j-dunc/POV-Display-V2/mechanical/solidworks/top_decal.png

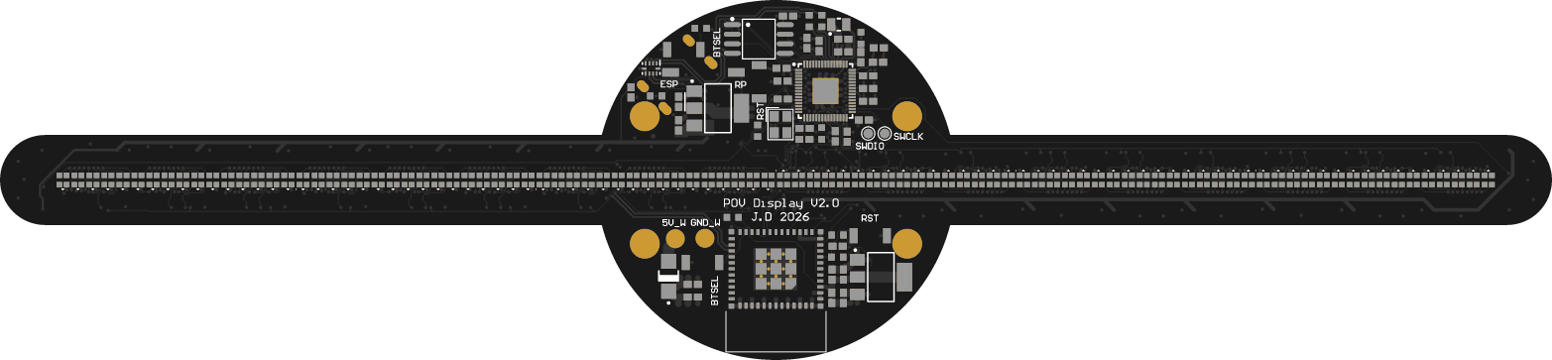
mechanical/solidworks/top_decal.png
