j-dunc/POV-Display-V2/hardware/fabrication/POV_DisplayV2-BOM.xlsx

Name | Description | Designator | Quantity | Manufacturer 1 | Manufacturer Part Number 1
Cap 100nF 0603 | 100nF 50V 10% X7R 0603 SMD Capacitor Decoupling | C1, C3, C4, C5, C6, C7, C8, C9, C10, C11, C12, C17, C23, C28_U_16_RGBs1, C28_U_16_RGBs2, C28_U_16_RGBs3, C28_U_16_RGBs4, C28_U_16_RGBs5, C28_U_16_RGBs6, C29_U_16_RGBs1, C29_U_16_RGBs2, C29_U_16_RGBs3, C29_U_16_RGBs4, C29_U_16_RGBs5, C29_U_16_RGBs6, C30_U_16_RGBs1, C30_U_16_RGBs2, C30_U_16_RGBs3, C30_U_16_RGBs4, C30_U_16_RGBs5, C30_U_16_RGBs6, C32, C34, C37 | 34 | Yageo Group | CC0603KRX7R9BB104
Cap 4.7uF 0603 | 4.7uF 16V 10% X5R 0603 SMD Capacitor | C2, C14, C15, C16 | 4 | Yageo Group | CC0603KRX5R8BB475
Cap 22uF 0603 | 22uF 6.3V 20% X5R 0603 SMD Capacitor | C13, C22, C31_U_16_RGBs1, C31_U_16_RGBs2, C31_U_16_RGBs3, C31_U_16_RGBs4, C31_U_16_RGBs5, C31_U_16_RGBs6, C33 | 9 | Samsung Electro-Mechanics | CL10A226MQ8NRNC
Cap 15pF 0603 | 15pF 50V 5% C0G 0603 SMD Capacitor | C18, C19 | 2 | Yageo Group | C0603C150K5GACTU
Cap 10uF 0603 | 10uF 6.3V 10% X5R 0603 SMD Capacitor | C20, C21, C35, C36 | 4 | Yageo Group | CC0603KRX5R5BB106
Cap 4.7nF 0603 | 4.7nF 50V 10% X7R 0603 SMD Capacitor | C24, C27 | 2 | Yageo Group | C0603C472J3RACTU
Cap 1nF 0603 | 1nF 50V 10% X7R 0603 SMD Capacitor | C25, C26 | 2 | Yageo Group | C0603C102F3GACAUTO
MBRA140T3G | Schottky Barrier Rectifier Diode 40 Volt 1A Automotive 2-Pin SMA | D1, D2 | 2 | onsemi | MBRA140T3G
AOTA-B201610S3R3-101-T | General Purpose Inductor, 3.3uH, 20%, 1 Element, SMD, 0806 | L1 | 1 | Abracon | AOTA-B201610S3R3-101-T
EKINGLUX E6C0606RGBC3UDA | 1.6*1.6*0.6mm RGB SMD CHIP LED | LED1_U_16_RGBs1, LED1_U_16_RGBs2, LED1_U_16_RGBs3, LED1_U_16_RGBs4, LED1_U_16_RGBs5, LED1_U_16_RGBs6, LED2_U_16_RGBs1, LED2_U_16_RGBs2, LED2_U_16_RGBs3, LED2_U_16_RGBs4, LED2_U_16_RGBs5, LED2_U_16_RGBs6, LED3_U_16_RGBs1, LED3_U_16_RGBs2, LED3_U_16_RGBs3, LED3_U_16_RGBs4, LED3_U_16_RGBs5, LED3_U_16_RGBs6, LED4_U_16_RGBs1, LED4_U_16_RGBs2, LED4_U_16_RGBs3, LED4_U_16_RGBs4, LED4_U_16_RGBs5, LED4_U_16_RGBs6, LED5_U_16_RGBs1, LED5_U_16_RGBs2, LED5_U_16_RGBs3, LED5_U_16_RGBs4, LED5_U_16_RGBs5, LED5_U_16_RGBs6, LED6_U_16_RGBs1, LED6_U_16_RGBs2, LED6_U_16_RGBs3, LED6_U_16_RGBs4, LED6_U_16_RGBs5, LED6_U_16_RGBs6, LED7_U_16_RGBs1, LED7_U_16_RGBs2, LED7_U_16_RGBs3, LED7_U_16_RGBs4, LED7_U_16_RGBs5, LED7_U_16_RGBs6, LED8_U_16_RGBs1, LED8_U_16_RGBs2, LED8_U_16_RGBs3, LED8_U_16_RGBs4, LED8_U_16_RGBs5, LED8_U_16_RGBs6, LED9_U_16_RGBs1, LED9_U_16_RGBs2, LED9_U_16_RGBs3, LED9_U_16_RGBs4, LED9_U_16_RGBs5, LED9_U_16_RGBs6, LED10_U_16_RGBs1, LED10_U_16_RGBs2, LED10_U_16_RGBs3, LED10_U_16_RGBs4, LED10_U_16_RGBs5, LED10_U_16_RGBs6, LED11_U_16_RGBs1, LED11_U_16_RGBs2, LED11_U_16_RGBs3, LED11_U_16_RGBs4, LED11_U_16_RGBs5, LED11_U_16_RGBs6, LED12_U_16_RGBs1, LED12_U_16_RGBs2, LED12_U_16_RGBs3, LED12_U_16_RGBs4, LED12_U_16_RGBs5, LED12_U_16_RGBs6, LED13_U_16_RGBs1, LED13_U_16_RGBs2, LED13_U_16_RGBs3, LED13_U_16_RGBs4, LED13_U_16_RGBs5, LED13_U_16_RGBs6, LED14_U_16_RGBs1, LED14_U_16_RGBs2, LED14_U_16_RGBs3, LED14_U_16_RGBs4, LED14_U_16_RGBs5, LED14_U_16_RGBs6, LED15_U_16_RGBs1, LED15_U_16_RGBs2, LED1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 | 96 | EKINGLUX | E6C0606RGBC3UDA
ESP32-C3-MINI-1-H4 | -96dBm 20.5dBm On-board PCB antenna 2.4GHz SMD, 13.2x16.6mm WiFi Modules ROHS | MD1 | 1 | Espressif Systems | ESP32-C3-MINI-1-H4
Res 5k1 0603 | 5.1k 1% 100mW 0603 SMD Resistor | R1, R2 | 2 | Yageo Group | RC0603FR-075K1L
Res 33R 0603 | 10R 1% 100mW 0603 SMD Resistor | R3 | 1 | Yageo Group | RT0603BRE0733RL
Res 27R 0603 | 27R 1% 100mW 0603 SMD Resistor | R4, R5 | 2 | Yageo Group | AC0603FR-0727RL
Res 1k 0603 | 1k 1% 100mW 0603 SMD Resistor | R6, R7, R8 | 3 | Yageo Group | SR0603FR-7T470RL
Res 100R 0603 | 100R 1% 100mW 0603 SMD Resistor | R9, R12 | 2 | Yageo Group | RC0603FR-13100RL
Res 4k7 0603 | 4.7k 1% 100mW 0603 SMD Resistor | R10, R11 | 2 | Yageo Group | AC0603FR-7W4K7L
Res 2k 0603 | 2k 1% 100mW 0603 SMD Resistor | R13_U_16_RGBs1, R13_U_16_RGBs2, R13_U_16_RGBs3, R13_U_16_RGBs4, R13_U_16_RGBs5, R13_U_16_RGBs6, R14_U_16_RGBs1, R14_U_16_RGBs2, R14_U_16_RGBs3, R14_U_16_RGBs4, R14_U_16_RGBs5, R14_U_16_RGBs6, R15_U_16_RGBs1, R15_U_16_RGBs2, R15_U_16_RGBs3, R15_U_16_RGBs4, R15_U_16_RGBs5, R15_U_16_RGBs6 | 18 | Yageo Group | AC0603FR-7W2KL
Res 10k 0603 | 10k 1% 100mW 0603 SMD Resistor | R16, R17, R18, R19 | 4 | Yageo Group | RC0603FR-0710KL
TS-1088-AR02016 | 3*4*2.0 160GF Surface mount no-post tactile switch | SW1, SW2, SW3, SW4 | 4 | Xunpu | TS-1088-AR02016
2.54-1P TPGT | 1 Digit SPST 24V Black 25mA 3000 times Flat Toggle, Raised Style SMD DIP Switches ROHS | SW5 | 1 | SHOU HAN | 2.54-1P TPGT
RP2350A-CT | Rp2350 Cortex-M33 Qfn-60 Ct |Raspberry-Pi RP2350A-CT | U1 | 1 | Raspberry Pi | RP2350A-CT
W25Q128JVSIQ | NOR Flash Serial (SPI, Dual SPI, Quad SPI) 3.3V 128M-bit 16M x 8 6ns 8-Pin SOIC Tube | U2 | 1 | Winbond | W25Q128JVSIQ
NCP1117ST33T3G | NCP1117 Series 1 A 3.3 V Fixed Output LDO Positive Voltage Regulator - SOT-223 | U3, U9 | 2 | onsemi | NCP1117ST33T3G
JSMSEMI A3144E-JSM | High-voltage-resistant and high-sensitivity unipolar Hall switch | U4, U5 | 2 | JSMSEMI | A3144E-JSM
Shenzhen Sunmoon Micro SM16206S | LED constant current driver chip, 16-channel constant current source output, externally adjustable output current, 25MHz clock frequency | U6_U_16_RGBs1, U6_U_16_RGBs2, U6_U_16_RGBs3, U6_U_16_RGBs4, U6_U_16_RGBs5, U6_U_16_RGBs6, U7_U_16_RGBs1, U7_U_16_RGBs2, U7_U_16_RGBs3, U7_U_16_RGBs4, U7_U_16_RGBs5, U7_U_16_RGBs6, U8_U_16_RGBs1, U8_U_16_RGBs2, U8_U_16_RGBs3, U8_U_16_RGBs4, U8_U_16_RGBs5, U8_U_16_RGBs6 | 18 | Shenzhen Sunmoon Micro | SM16206S
TS3USB221RSER | IC Usb Switch Dual 1X2 10UQFN Usb Switch IC 2 Channel 10-UQFN (2.0X1.5) | U10 | 1 | Texas Instruments | TS3USB221RSER
TYPE-C-31-M-12 | USB Type-C Connector Female SMD 16 pin | USBC1 | 1 | HRO Electronics | TYPE-C-31-M-12
ABM8-272-T3 | Parallel - Fundamental Quartz Crystal, 12MHz Nom | Y1 | 1 | Abracon | ABM8-272-T3
