j-dunc/POV-Display-V2/mechanical/step/Rubber_Base_V1.1.STEP

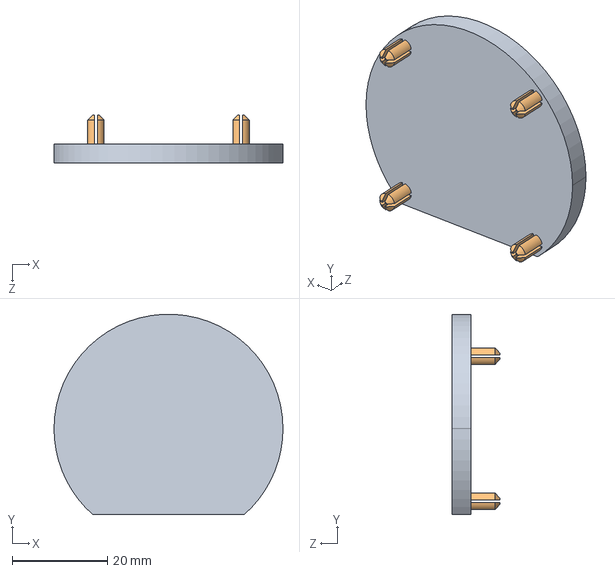
[picture p4: CAD file, 2026-10-17]
mechanical/step/Rubber_Base_V1.1.STEP
48.0 x 42.0 x 10.0 mm
