j-dunc/POV-Display-V2/mechanical/solidworks/Rubber_Base_V1.SLDPRT

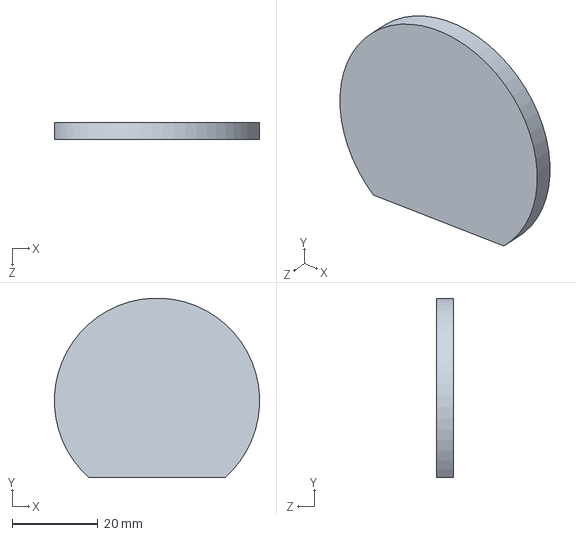
[picture p5: CAD file, 2026-10-17]
mechanical/solidworks/Rubber_Base_V1.SLDPRT
47.9 x 42.0 x 4.00 mm
