j-dunc/POV-Display-V2/mechanical/step/Motor_Mount_V1.4.STEP

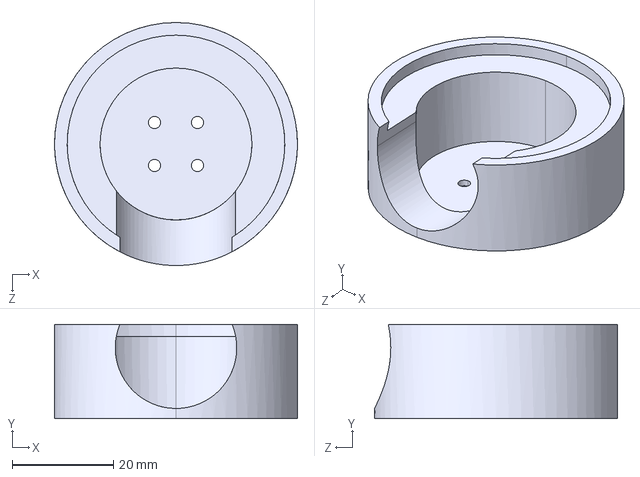
[picture p6: CAD file, 2026-10-17]
mechanical/step/Motor_Mount_V1.4.STEP
48.0 x 18.6 x 48.0 mm
