j-dunc/POV-Display-V2/mechanical/solidworks/POV_DisplayV2_PCB.step

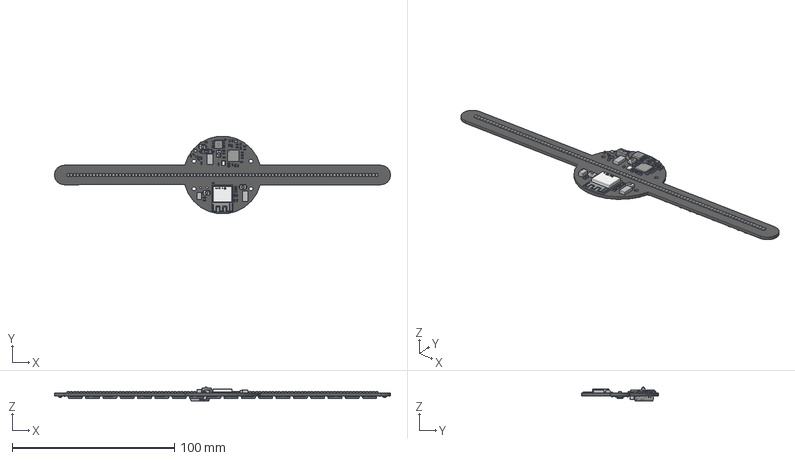
[picture p7: CAD file, 2026-10-17]
mechanical/solidworks/POV_DisplayV2_PCB.step
206.9 x 47.7 x 8.70 mm
Yageo Logo x 34
name x 57
SW-SMD_2P-L6.2-W2.5-LS9.4
Extruded x 6
SW-SMD_L3.9-W2.9-H2.0-LS4.8 x 4
ESP32-C3-MINI-1-N4--3DModel-STEP-1
Espressif Logo Adjustable
ThermalPin
PinsArrayLR
PinsArrayTB
QSOP-24_L8.7-W3.9-H1.6-LS6.0-P0.64 x 18
Pins x 96
CRYSTAL-SMD_4P-L3.2-W2.5-BL
USB-C_SMD-TYPE-C-31-M-12_1
SOT-23-3L_L2.9-W1.6-H1.1-LS2.8-P0.95 x 2
SOIC-8_L5.3-W5.3-H1.9-LS7.9-P1.27
IND-SMD_L2.0-W1.6_AOTA-B201610S3R3-101-T
