j-dunc/POV-Display-V2/mechanical/step/PCB_Mount_V1.5.STEP

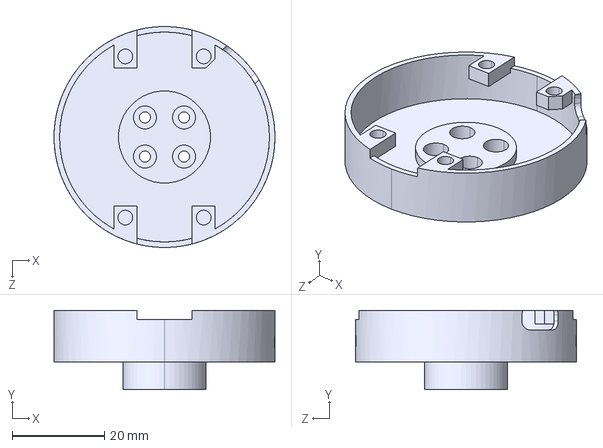
[picture p8: CAD file, 2026-10-17]
mechanical/step/PCB_Mount_V1.5.STEP
48.0 x 17.2 x 48.0 mm
