j-dunc/POV-Display-V2/mechanical/step/Neck_V1.4.STEP

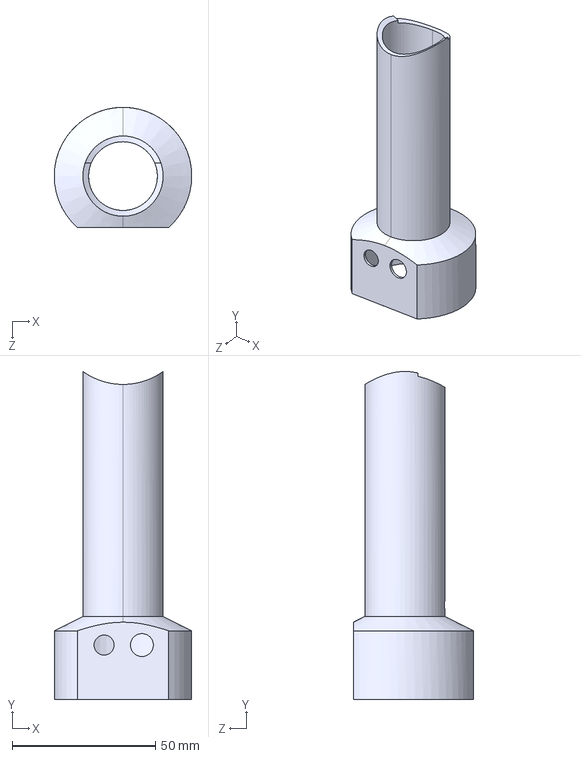
[picture p9: CAD file, 2026-10-17]
mechanical/step/Neck_V1.4.STEP
48.0 x 114.5 x 42.0 mm
