j-dunc/POV-Display-V2/mechanical/step/Motor_Mount_Screw_Cover_V1.2.STEP

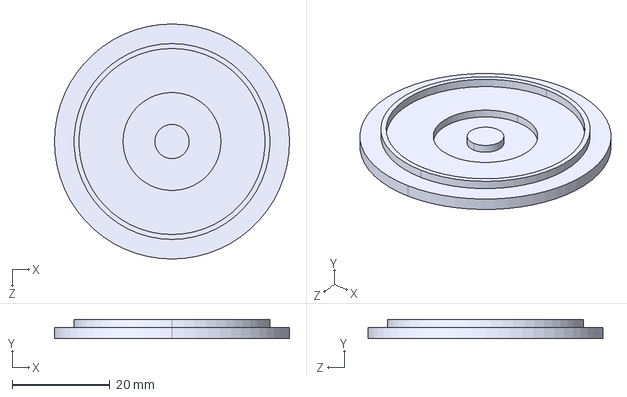
[picture p10: CAD file, 2026-10-17]
mechanical/step/Motor_Mount_Screw_Cover_V1.2.STEP
48.0 x 3.90 x 48.0 mm
