j-dunc/POV-Display-V2/mechanical/solidworks/POV_DisplayV2.SLDASM

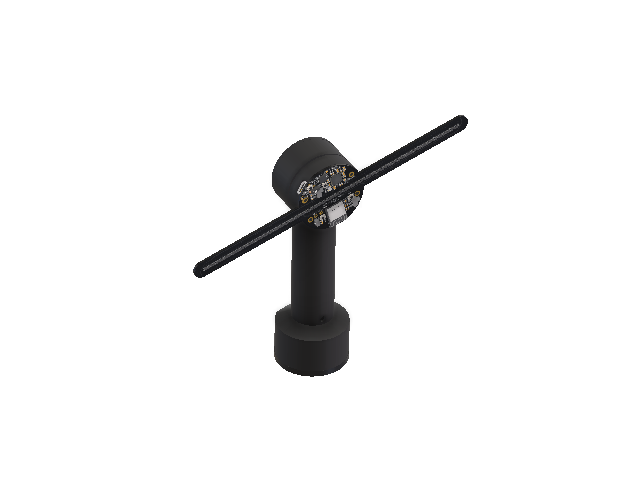
[picture p11: CAD file, 2026-10-17]
mechanical/solidworks/POV_DisplayV2.SLDASM
PCB_Mount_V1.5
1.step x 34
2.step x 34
3.step x 34
Yageo Logo.step x 34
2-0.step x 57
name.step x 57
1-1.step x 57
SW-SMD_2P-L6.2-W2.5-LS9.4.step
Extruded.step
Extruded-2.step
Extruded-3.step x 2
SW-SMD_L3.9-W2.9-H2.0-LS4.8.step x 4
1-5.step
2-6.step
3-7.step
4.step
5.step
ESP32-C3-MINI-1-N4--3DModel-STEP-1.step
Espressif Logo Adjustable.step
Body.step
ThermalPin.step
PinsArrayLR.step
PinsArrayTB.step
QSOP-24_L8.7-W3.9-H1.6-LS6.0-P0.64.step x 18
Body-8.step x 96
Pins.step x 96
CRYSTAL-SMD_4P-L3.2-W2.5-BL.step
USB-C_SMD-TYPE-C-31-M-12_1.step
SOT-23-3L_L2.9-W1.6-H1.1-LS2.8-P0.95.step x 2
SOIC-8_L5.3-W5.3-H1.9-LS7.9-P1.27.step
IND-SMD_L2.0-W1.6_AOTA-B201610S3R3-101-T.step
Extruded-9.step
Extruded-10.step
Motor_Mount_V1.4
Motor_Mount_Screw_Cover_V1.2
Neck_V1.4
Rubber_Base_V1
