j-dunc/POV-Display-V2/(list of files, cad)

Other CAD files:
mechanical/solidworks/Motor_Mount_Screw_Cover_V1.2.SLDPRT
mechanical/solidworks/Motor_Mount_V1.4.SLDPRT
mechanical/solidworks/Neck_V1.4.SLDPRT
mechanical/solidworks/PCB_Mount_V1.5.SLDPRT
mechanical/solidworks/POV_DisplayV2_PCB.SLDASM
