j-dunc/POV-Display-V2/docs/schematics.pdf

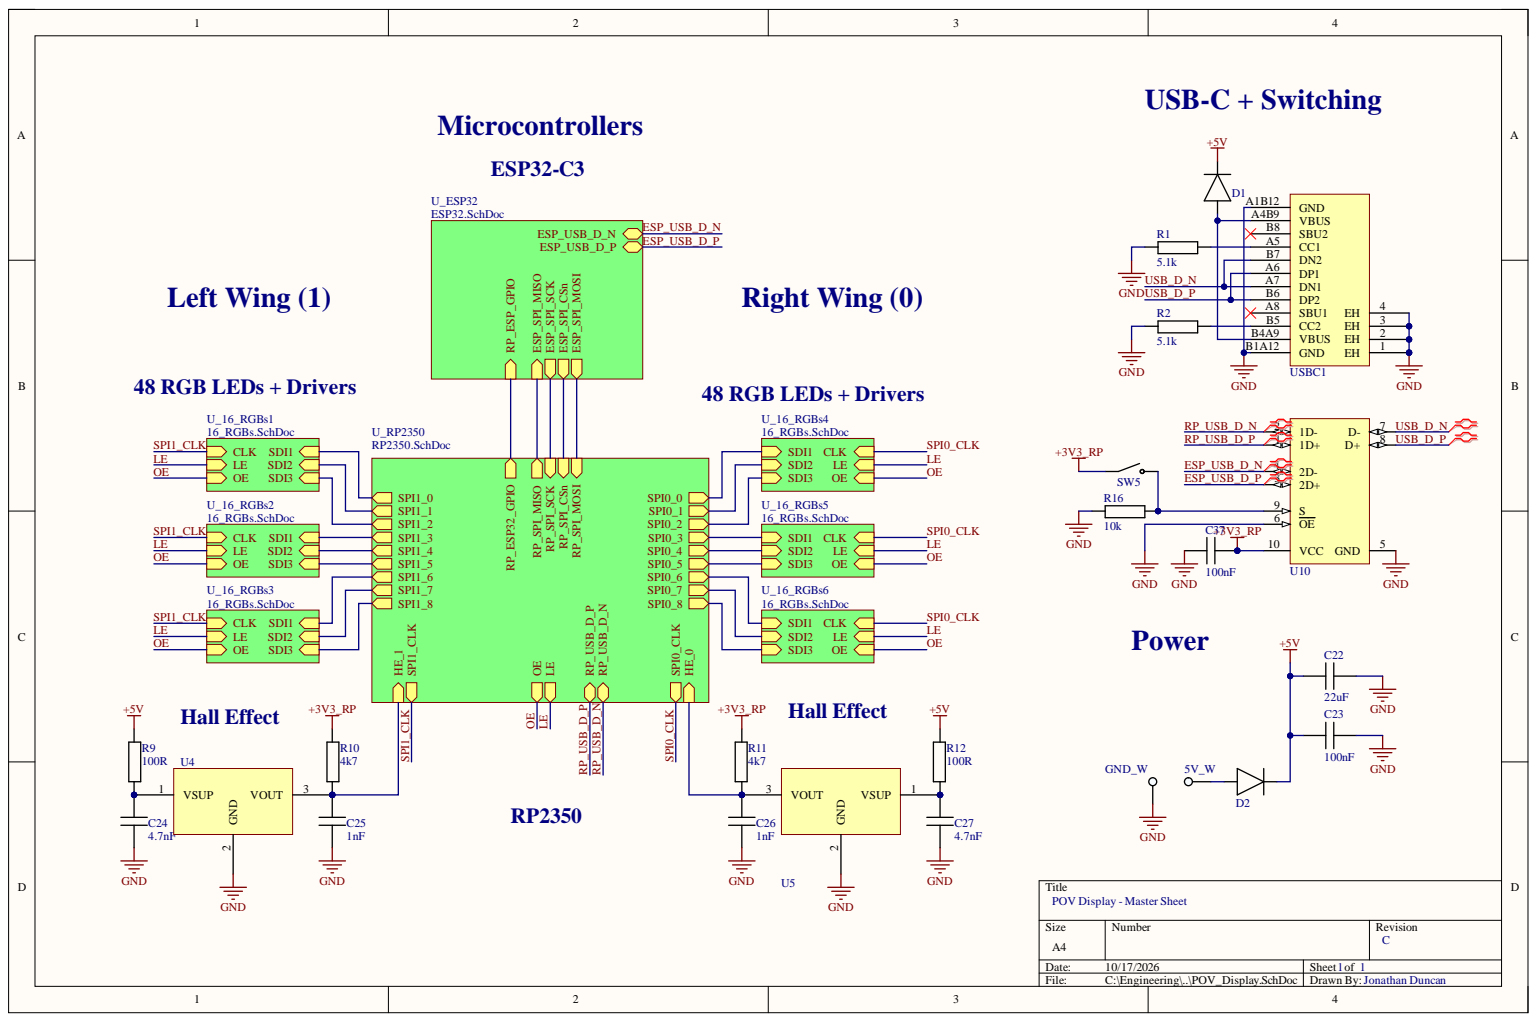
[picture p12: page 1]

Title
POV Display - Master Sheet

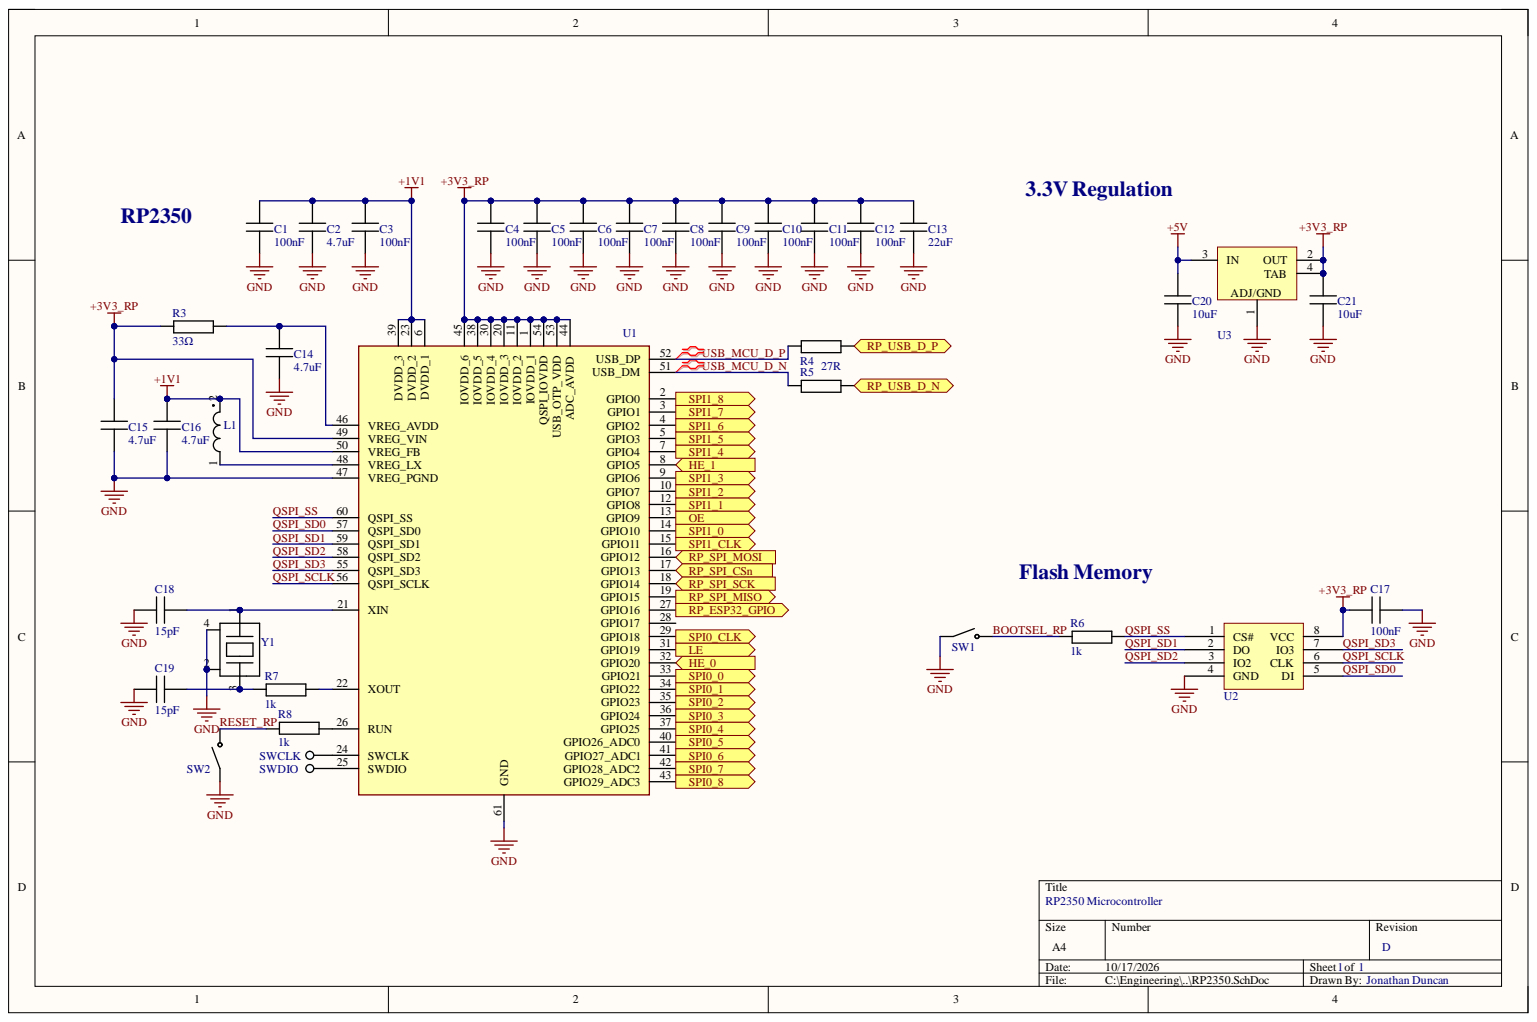
[picture p13: page 2]

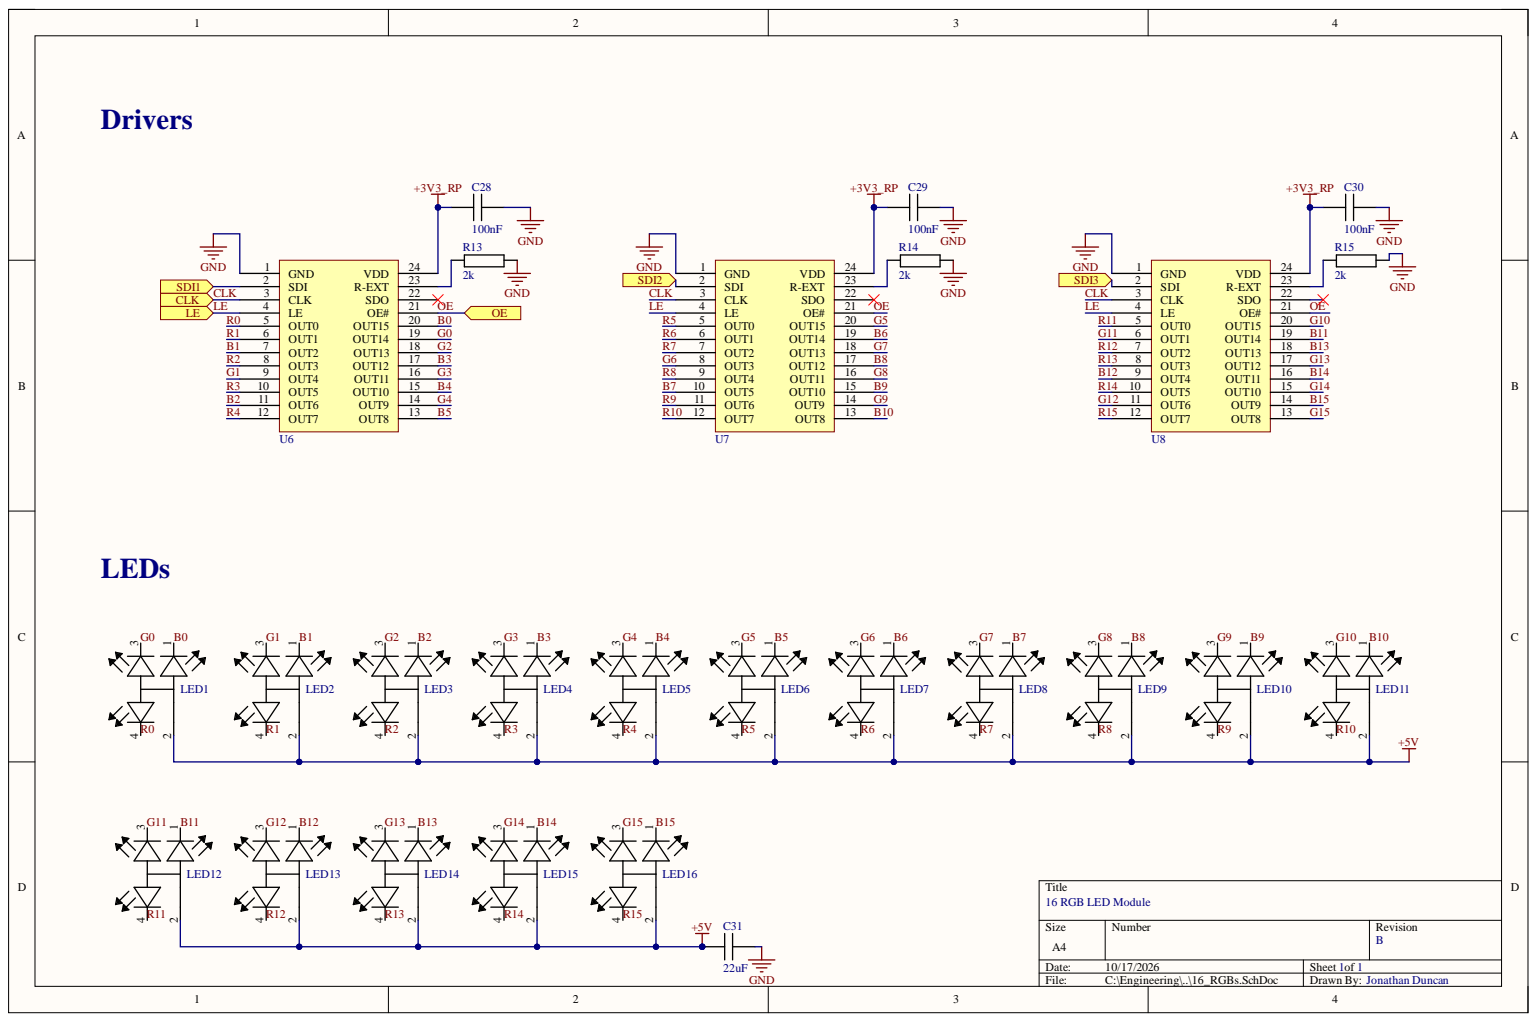
[picture p14: page 3]

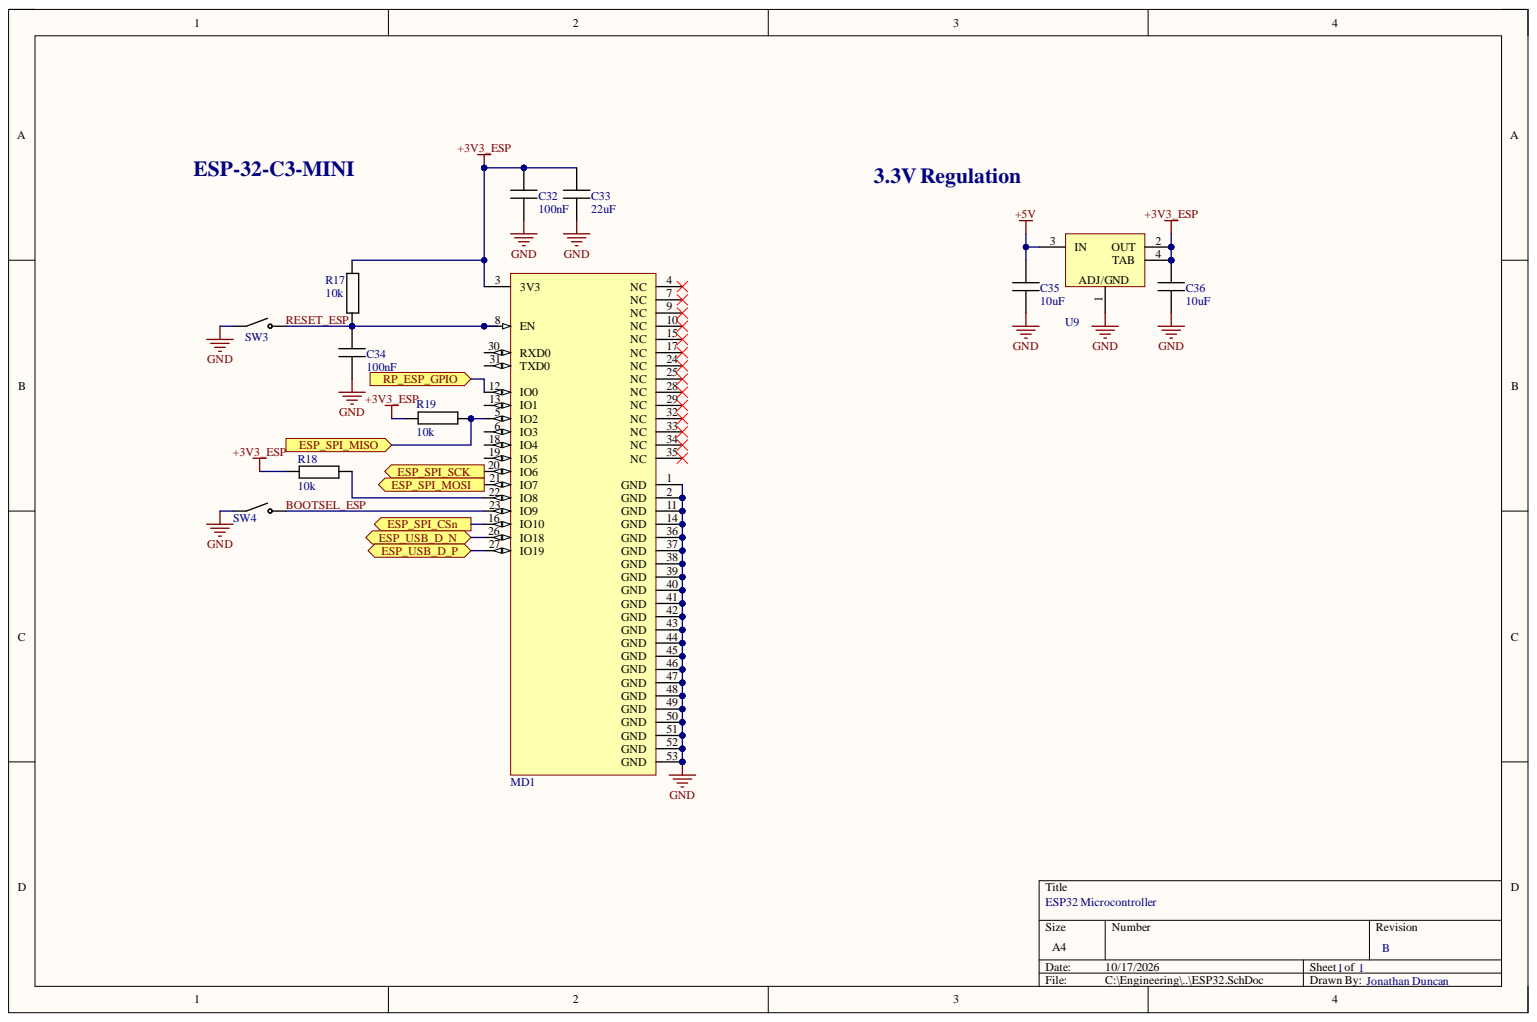
[picture p15: page 4]

ESP_SPI_MO S I | 2 1
