j-dunc/POV-Display-V2/(list of files, drawings)

Other design files:
hardware/altium/16_RGBs.SchDoc
hardware/altium/ESP32.SchDoc
hardware/altium/POV_Display.PcbDoc
hardware/altium/POV_Display.SchDoc
hardware/altium/RP2350.SchDoc
