j-dunc/POV-Display-V2/firmware/rp2350-display/main.c

// main: entry point. Boots the SPI link on core 1, initialises drivers and
// render state, then runs the render loop on core 0

#include <stdio.h>

#include "pico/stdlib.h"
#include "pico/multicore.h"
#include "pico/flash.h"
#include "led_shift.h"
#include "hall_sensor.h"
#include "led_map.h"
#include "shift_encoder.h"
#include "image_source.h"
#include "animation_store.h"
#include "render.h"
#include "spi_link.h"

int main(void)
{
    stdio_init_all();

    led_shift_init();
    hall_sensor_init();
    build_led_map();
    shift_encoder_init();
    rebuild_calibration();
    render_init(); // display blanked until something uploaded
    animation_store_init(); // replays the last uploaded animation, if there is one
    flash_safe_execute_core_init();

    // Blocking loop on core 1: handles SPI commands, and builds animation frames in the gaps
    multicore_launch_core1(spi_link_command_loop);

    while (true) {
        render_update();
    }
}
