j-dunc/POV-Display-V2/firmware/esp32-ui/main/pins.h

#pragma once

// ESP32-C3 pin map

#define PIN_RP_ESP_GPIO 0   // spare line to RP2350, unassigned
#define PIN_SPI_MISO    2   // FSPIQ, dedicated IO_MUX pin
#define PIN_SPI_SCK     6   // FSPICLK, IO_MUX
#define PIN_SPI_MOSI    7   // FSPID, IO_MUX
#define PIN_SPI_CS      10  // FSPICS0, IO_MUX
