j-dunc/POV-Display-V2/(commit log)

2026-08-30 docs(hardware): include V2 pin mappings and hardware architecture documentation
2026-08-30 chore: add firmware scaffolding for RP2350 and ESP32-C3 targets
    Generated via the Pico SDK and ESP-IDF VS Code extensions, plus a
    .gitignore covering build artifacts and toolchain installs for both.
2026-08-31 chore: create header files for pin and led chain mappings
2026-08-31 Feat: add board_init function to intialise all pins to a safe idle state
2026-08-31 feat: add parallel shift register driver using PIO and DMA
2026-08-31 test: test all-on/all-off leds to test shift register driver
2026-09-03 feat: map led position, channel pairs to chip, pin pairs
2026-09-07 feat: implement functions to convert frame buffer to word array
2026-09-07 fix: reverse led pin order to correct for shift register order
    [frame_buffer.c]
2026-09-07 test: light each led channel individual to test frame buffer module
2026-09-07 fix: change word size for dma to 16 bit to save space
    [frame_buffer.c, frame_buffer.h, led_shift.c, led_shift.h, main.c]
2026-09-07 feat: use hall effect sensors to measure period and RPM,. with logging
2026-09-07 feat: use both hall effect sensors to calculate current angle, period, and rpm
2026-09-10 fix: fix hall sensor stale / growing angle bug
    [hall_sensor.c]
2026-09-10 feat: change frame buffers to contain brightness of channels and map to word arrays for a given bitplane
2026-09-10 test: add colour wheel test image
2026-09-11 fix: return to 6-bit depth
    [frame_buffer.h]
2026-09-11 fix: split BCM planes into a palindrome to centre in a pixel
    [render.c]
2026-09-11 fix: time bcm planes in cycles not us to increase resolution
    [render.c]
2026-09-11 fix: split shift register shifting into load and latch phases
    [led_shift.c, led_shift.h]
2026-09-11 fix: make shifting non blocking and occur during existing off periods to eliminate column overrun
    [led_shift.c, led_shift.h, render.c]
2026-09-11 fix: round rather than truncate levels
    [image_source.c]
2026-09-11 fix: use preprocessor if for testing logs
    [main.c]
2026-09-11 test: simulate hall pulses for logic analyser testing
2026-09-11 fix: use exact cycle counts to self-correct for overhead in planes
    [render.c]
2026-09-11 fix: don't split smallest plane to ensure overhead fits in off-time
    [render.c]
2026-09-11 fix: clamp column time to reduce overrun
    [render.c]
2026-09-12 fix: schedule columns in a set number of cycles so columns cannot overrun
    [main.c, render.c]
2026-09-12 chore: pin map for ESP32
2026-09-12 feat: setup and test SPI link ESP32 - RP2350
2026-09-13 feat: setup SPI protocol with status command
2026-09-14 feat: send columns over spi
2026-09-16 feat: add /calibrate page with per channel scale, gamma, and radial gamma
2026-09-16 fix: get calibration values live from RP2350 for slider defaults
    [image_source.c, image_source.h, spi_link.c, spi_link.h, web_server.c, web_server.h]
2026-09-16 chore: delete unused esp32 test_pattern
2026-09-16 feat: add calibration test images with previews
2026-09-16 feat: switch to 16x16 bayer matrix
2026-09-16 chore: move all board_init code into corresponding module files
2026-09-16 chore: organise rp2350 and esp32 folder structures
2026-09-16 fix: update calibration values
    [image_source.c]
2026-09-16 fix: use lookup tables for calibration scaling and shift positions rather than computing per pixel / frame
    [frame_buffer.c, frame_buffer.h, image_source.c, image_source.h, main.c]
2026-09-16 feat: double buffer frame buffers
2026-09-16 refactor: move all buffering into frame_buffer.c
2026-09-17 feat: move simulated hall to hall_effect to completely replace hall sensor
    [hall_sensor.c, render.c]
2026-09-17 fix: add debounce to hall effect
    [hall_sensor.c]
2026-09-17 fix: move ready line handshake to read and write SPI functions, and don't raise ready until FIFO full
    [spi_link.c]
2026-09-17 fix: fix wraparound on revolution boundary logic
    [render.c]
2026-09-17 refactor: move max_duty_fraction to same struct as rest of calibration
2026-09-17 fix: use one shared frame buffer for LHS and RHS wings
    [frame_buffer.c, frame_buffer.h, image_source.c, test_patterns.c]
2026-09-17 refactor: update naming, comments, and structure to clear ambiguity with frame buffer vs frame vs word array vs column vs plane
2026-09-18 feat: add animation spi and http endpoints
2026-09-19 fix: reset animation before unblanking display on upload
    [animation.c, animation.h, spi_link.c]
2026-09-19 feat: add frame count to flash so last uploaded animation persists power cycle
2026-09-19 fix: send stills via animation endpoint so they persist in flash
    [web_server.c]
2026-10-17 chore: add final hardware files to repo
    [16_RGBs.SchDoc, ESP32.SchDoc, POV_Display.PcbDoc, POV_Display.SchDoc, POV_DisplayV2-BOM.xlsx, RP2350.SchDoc]
2026-10-17 chore: add mcad files to repo
    [Motor_Mount_Screw_Cover_V1.2.SLDPRT, Motor_Mount_Screw_Cover_V1.2.STEP, Motor_Mount_V1.4.SLDPRT, Motor_Mount_V1.4.STEP, Neck_V1.4.SLDPRT, Neck_V1.4.STEP, PCB_Mount_V1.5.SLDPRT, PCB_Mount_V1.5.STEP]
